Cause-Effect-Pedals/FET-Dream/LTSpice/README.rst

Just a couple of examples of LTSpice file and output from the early conceptual days of the pedal.  Can't support this as I can't get it to run anymore myself!
