Cause-Effect-Pedals/FET-Dream/ExpressPCB/README.rst

This directory includes the custom pcb components, sch components and sch symbols used in the project.
