Cause-Effect-Pedals/FET-Dream/Design_Files/201011-11-j204 value calculations.xls

Adjust Rs trimmer for Vs first then adjust Rd for Vd
2021-02-24
Vcc | 8.44 |  | TR2 | TR1 | W5 | W4 |  |  |  |  | TR2 | TR1
Sample # | Idss (mA) | Vp (V) | Rs (ohm) | Rd (ohm) | Vs (V) | Vd (V) | Id (mA) | Av (V/V) | Vo (Vpp) | Cp (nF) | Fudge | Fudge
1 | 2.481 | 1.2482 | 417.5759774 | 2156.082225 | 0.485 | 5.938 | 1.14 | 2.6 | 5.94 | 381.1400839 | 530.3214913 | 2725.287932
2 | 2.205 | 1.1787 | 443.6829932 | 2482.693878 | 0.457 | 5.889 | 1.01 | 2.8 | 6.08 | 358.7131928 | 563.4774014 | 3138.125061
3 | 2.141 | 1.1554 | 447.9131247 | 2576.496964 | 0.447 | 5.873 | 0.98 | 2.9 | 6.13 | 355.3254734 | 568.8496684 | 3256.692163
4 | 2.1 | 1.1509 | 454.8795238 | 2630.657143 | 0.445 | 5.870 | 0.96 | 2.9 | 6.14 | 349.8837269 | 577.6969952 | 3325.150629
5 | 2.548 | 1.2832 | 417.9968603 | 2074.66248 | 0.500 | 5.962 | 1.18 | 2.5 | 5.87 | 380.7563123 | 530.8560126 | 2622.373375
6 | 2.471 | 1.2515 | 420.3743424 | 2162.403885 | 0.487 | 5.940 | 1.14 | 2.6 | 5.94 | 378.6028952 | 533.8754148 | 2733.278511
7 | 2.507 | 1.2575 | 416.324292 | 2127.044276 | 0.489 | 5.944 | 1.16 | 2.5 | 5.92 | 382.2859875 | 528.7318508 | 2688.583965
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
