Cause-Effect-Pedals/FET-Dream/Design_Files/FET_Dream0v8_c.bmp

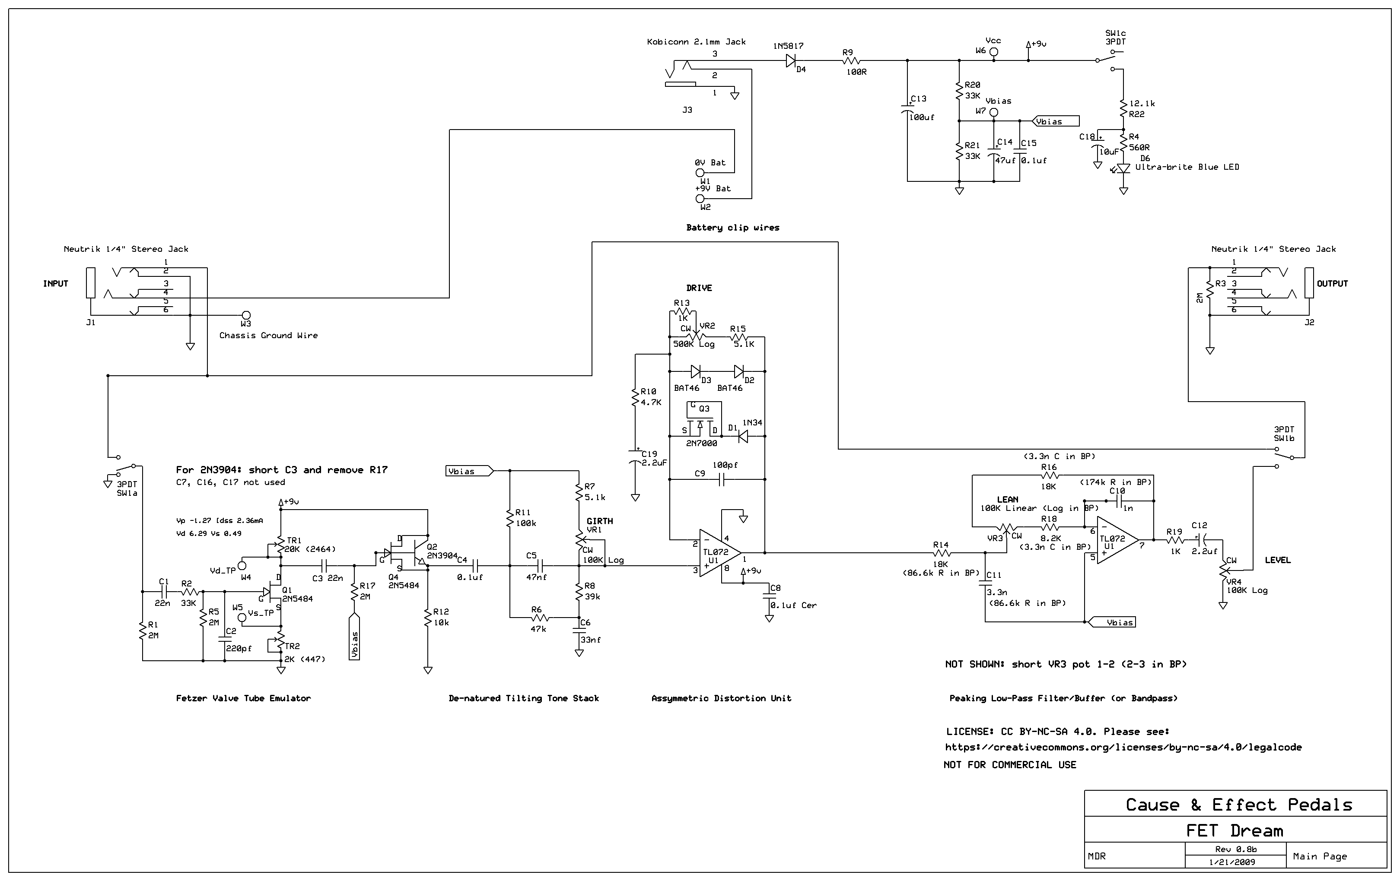
Design_Files/FET_Dream0v8_c.bmp
