Cause-Effect-Pedals/FET-Dream/Design_Files/FET_Selection_Circuit.jpg

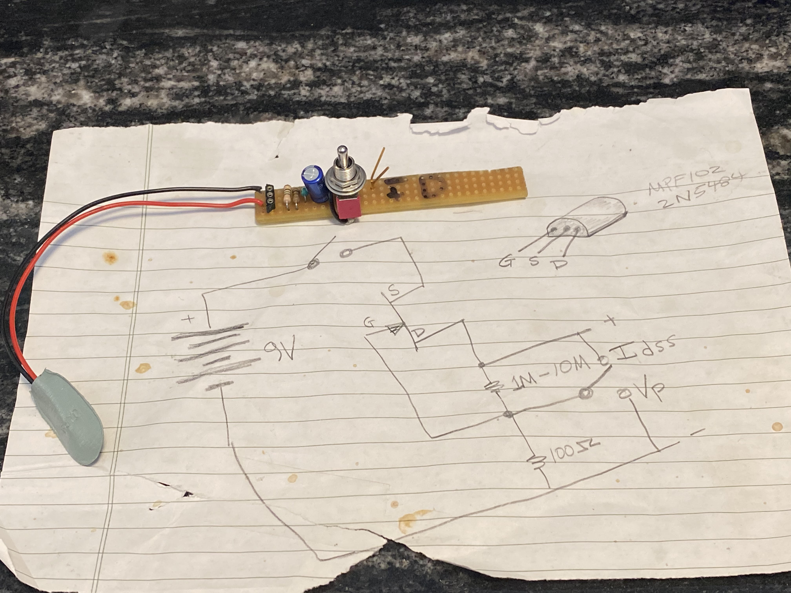
Design_Files/FET_Selection_Circuit.jpg
