Cause-Effect-Pedals/FET-Dream/web-image-w-reflect1000x162.png

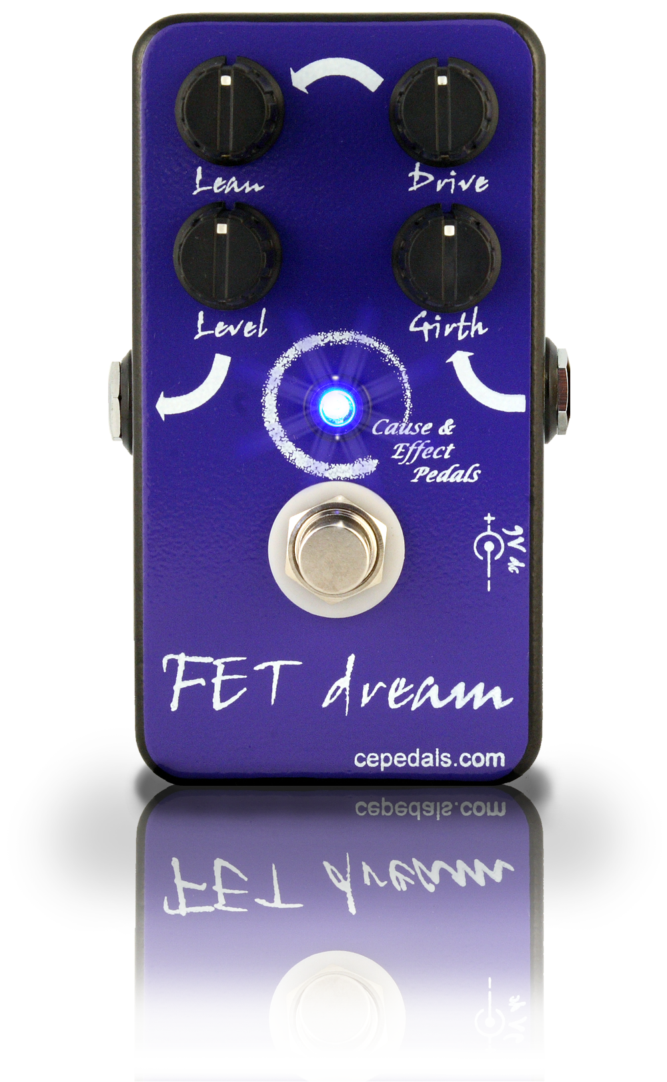
web-image-w-reflect1000x162.png
