Cause-Effect-Pedals/FET-Dream/Design_Files/Dec-20-2009-FET_Dream_BOM_1v2.xls

Part ID | Value | Notes | Mfr Part No. | Source | Src. Part No.
C1 | 0.022uf | Film, coupling | ECQ-B1H223JF | DigiKey | P4586-ND
C10 | .001uF | Film, filter, 2% | ECQ-B1H102JF (5%) | DigiKey | P4551-ND
C11 | .0033uF | Film, filter, 2% | ECQ-B1H332JF (5%) | DigiKey | P4557-ND
C2 | 220pf | Film, filter | ECQ-B1H221KF | DigiKey | P4574-ND
C4 | 0.1uf | Film, coupling | ECQ-V1H104JL | DigiKey | P4525-ND
C5 | 0.047uf | Film, filter, 2% | ECQ-V1H473JL (5%) | DigiKey | P4521-ND
C6 | 0.033uf | Film, filter, 2% | ECQ-B1H333JF (5%) | DigiKey | P4569-ND
Ferrule | 5mm diode ferrule |  | Lumex SSH-LXH501 | DigiKey | 67-1333-ND
Presence | 1uf 63V |  |  | DigiKey | P4548-ND
TR1 | 5K | Murata 10mm | PV36X203C01B00 | DigiKey | 490-2907-ND
TR2 | 1K | Murata 10mm | PV36X202C01B00 | DigiKey | 490-2893-ND
U1 | TL072 | or other 'toneful' op amp | TL072CP | DigiKey | 296-1775-5-ND
Knobs (4) | 1/4" shaft, set screw | ribbed, .625" | PN-8F | Ebay | HongKongSuperSeller
PCB |  |  |  | ExpressPCB
Label |  | Silkscreen | Inkech AM series | Graphic Commerce
Battery | 9V |  | Energizer Max | Loblaws
Bus Bar Wire Extensions for pot leads |  | Beldon | 20 gauge SS wire | Mouser | 566-8020
C12,C19 | 2.2uf - 2mm LS | Electrolytic (coupling) | ECE-A1EKK2R2 | Mouser | 140-MLRH50V2.2-RC
C13,C14 | 100uf - 3.5mm LS | Electrolytic (power) | ECA-1EHG101 2.5mm LS | Mouser | 140-XRL35V100-RC
C18 | 10uf - 2mm LS | Electrolytic (power) | Xicon 140-XRL25V10-RC | Mouser | 140-XRL25V10-RC
C8,C15 | 0.1uf Cer | Ceramic decoupling |  | Mouser | 594-A104K15X7RF5UAA
C9 | 100pf - 2.5mm LS | Ceramic disc, filter | Xicom 140-50P2-101K-RC | Mouser | 140-50S2-101J-RC
D1 | 1N34 | Germanium |  | Mouser | 526-1N34A
D2,D3 | BAT46 | Schottky Barrier | BAT46 | Mouser | 511-BAT46
D4 | 1N5817 | Schottky 20V, 1A | 1N5817 | Mouser | 625-1N5817-E3
D6 | Blue LED 2200mcd | Kingbright 20deg | WP7113QBC/D | Mouser | 604-WP7113QBC/D
J1.J2 | Neutrik 1/4" Stereo Jack |  | NMJ6HCD2 | Mouser | 550-22302
J3 | Kobiconn 2.1mm Jack | PC Mount | 163-179PH-EX | Mouser | 163-179PH-EX
Q1 | J204 | Fetzer | J204-E3 | Mouser | 781-J204-E3
Q2 | 2N3904 | Follower | 2N3904 | Mouser | 512-2N3904D81Z
Q3 | 2N7000 | Distortion MOSFET | 2N7000 | Mouser | 512-2N7000D74Z
R1,R3,R5 | 2M | Metal | Xicon 1% | Mouser | 271-2.0M-RC
R10 | 4.7K | Metal | Xicon 1% | Mouser | 271-4.7K-RC
R11 | 100K | Metal | Xicon 1% | Mouser | 271-100K-RC
R12 | 10K | Metal | Xicon 1% | Mouser | 271-10K-RC
R13,R19 | 1K | Metal | Xicon 1% | Mouser | 271-1K-RC
R14,R16 | 18K | Metal | Xicon 1% | Mouser | 271-18K-RC
R18 | 8.2K | Metal | Xicon 1% | Mouser | 271-8.2K-RC
R2,R20,R21 | 33K | Metal | Xicon 1% | Mouser | 271-33K-RC
R22 | 12K | Metal | Xicon 1% | Mouser | 271-12K-RC
R4 | 560R | Metal | Xicon 1% | Mouser | 271-560-RC
R6 | 47K | Metal | Xicon 1% | Mouser | 271-47K-RC
R7,R15 | 5.1K | Metal | Xicon 1% | Mouser | 271-5.1K-RC
R8 | 39K | Metal | Xicon 1% | Mouser | 271-39K-RC
R9 | 100R | Metal | Xicon 1% | Mouser | 271-100-RC
Socket | 8pin DIP | Tyco 'Econ-Ladder' | 1-390261-2 | Mouser | 571-1-390261-2
VR1,VR4 | 100K Log | Alpha 16mm | RV16AF-10-15S1-A100K | Mouser | 313-1500F-100K
VR2 | 500K Log | Alpha 16mm | RV16AF-10-15S1-A500K | Mouser | 313-1500F-500K
VR3 | 100K Linear | Alpha 16mm | RV16AF-10-15R1-B100K | Mouser | 313-1000F-100K
W1 & W2 | 9V insulated battery clip | Battery clip | Keystone 81-4 | Mouser | 534-81-4
 | Neutrik 1/4" Stereo Jack | J2 Can be mono | NMJ6HCD2 | Mouser | 550-22302
Enclosure | 1290NS | Black Powder Coat | 1290NS | NS | 1290NSBL-16B010
SW1 | 3PDT | EH Blue 3PDT | 3PDT Switch | NS | SW3PDT-03A130
Tooth Washers | Alpha pot tooth washers | "internal tooth" | 7mm internal or .268" | OFS | SS 1/4" tooth washer only
Mailer | D/C 7 1/8 X 5 X 3, 175lb Oyster |  |  | Packaging World
W3 | Chassis Ground Wire | solder to V4 | 22 gauge coated | Sayal
Box | 5"X3"X2" | Oyster | S-461 | Uline | S-461
