Cause-Effect-Pedals/FET-Dream/LTSpice/FET_Dream7_7b_new_filters_LPx3.pdf

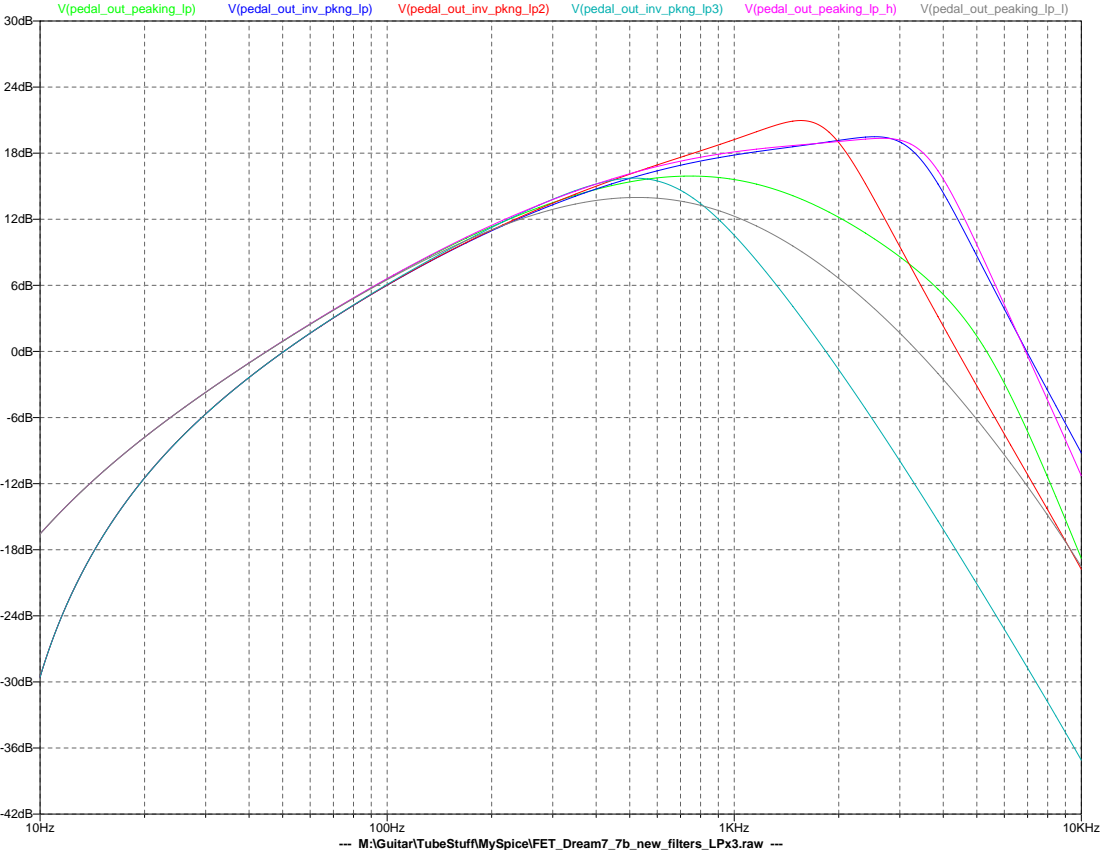
[picture p5: page 1]
1KHz; 10KHz; V(pedal_out_peaking_lp); V(pedal_out_inv_pkng_lp); V(pedal_out_inv_pkng_lp2); V(pedal_out_inv_pkng_lp3); V(pedal_out_peaking_lp_h); V(pedal_out_peaking_lp_l)

--- M:\Guitar\TubeStuff\MySpice\FET_Dream7_7b_new_filters_LPx3.raw ---
