Cause-Effect-Pedals/FET-Dream/FET_Dream_Schematic.pdf

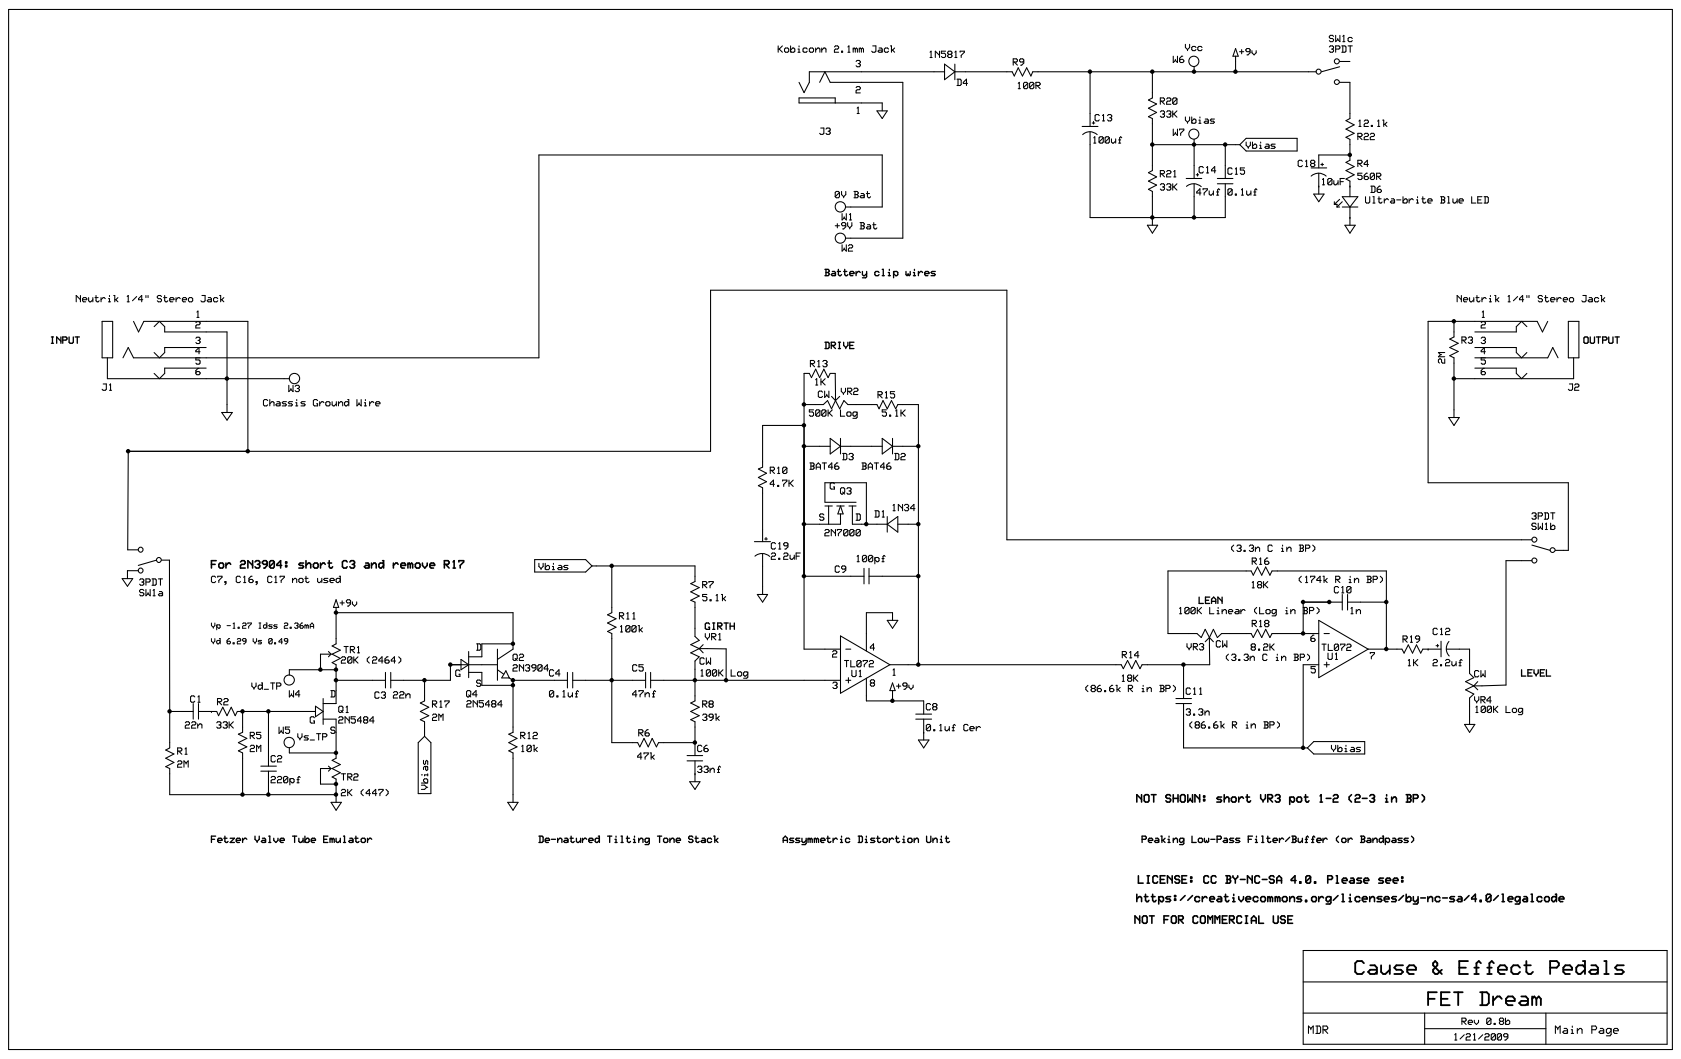
[picture p6: page 1]
