Cause-Effect-Pedals/FET-Dream/LTSpice/FET_Dream_0v8_5_dopple.asc

C1: cap; 33n
C2: cap; 22n
C3: cap; 220p
C4: cap; .22u
C5: cap; 100p
C6: cap; 10n
C7: cap; .47u
C8: cap; 22n
C9: cap; 2.2u
C10: cap; 1n
C11: cap; 33n
C12: cap; 47n
C13: cap; 10u
C14: cap; 47u
C15: cap; 220p
C16: cap; 22n
C17: cap; .1u
C18: cap; 2.2u
C19: cap; 3.3n
C20: cap; 10u
C21: cap; 47u
C22: cap; 22n
C23: cap; 220p
C24: cap; 100p
C25: cap; 1n
C26: cap; 33n
C27: cap; .047u
C28: cap; 47n
C29: cap; 2.2u
C30: cap; 47n
C31: cap; .1u
C32: cap; 10n
C33: cap; 2.2u
C34: cap; 3.3n
C35: cap; 10u
C36: cap; 47u
C39: cap; 100p
C40: cap; 1n
C42: cap; 2.2u
C43: cap; 33n
C44: cap; 47n
C45: cap; 220p
C46: cap; .1u
C47: cap; 2.2u
C48: cap; 3.3n
C49: cap; 10u
C50: cap; 47u
C51: cap; 22n
C53: cap; 100p
C54: cap; 1n
C56: cap; 2.2u
D1: schottky; BAT54
D2: schottky; BAT54
D3: diode; 1N914
D4: diode; 1N914
D5: diode; 1N914
D6: diode; 1N914
D7: schottky; BAT54
D8: diode; 1N914
D9: diode; 1N914
D10: schottky; BAT54
D11: diode; 1N914
D12: diode; 1N914
J1: njf; 2N5484
J2: njf; 2N5484
J3: njf; J112
J4: njf; 2N5484
J5: njf; J112
J6: njf; J112
J7: njf; J201b
Q1: npn; 2N3904
Q2: npn; 2N3904
R1: res; 10k
R2: res; 1
R3: res; 50k
R4: res; 250k
R5: res; 1Meg
R6: res; 33k
R7: res; 33k
R8: res; 816
R9: res; 470k
R10: res; 184
R11: res; 33k
R12: res; 47k
R13: res; 470k
R14: res; 250k
R15: res; 250k
R16: res; 1k
R17: res; 1
R18: res; 18k
R19: res; 1k
R20: res; 97.6k
R21: res; 1
R22: res; 4.7k
R23: res; 2.4k
R24: res; 5.1k
R25: res; 470k
R26: res; 10k
R27: res; 5.1k
R28: res; 10k
R29: res; 39k
R30: res; 100k
R31: res; 2.2meg
R32: res; 33k
R33: res; 816
R34: res; 47k
R35: res; 184
R36: res; 33k
R37: res; 33k
R38: res; 250k
R39: res; 250k
R40: res; 1k
R41: res; 1
R42: res; 18k
R43: res; 1k
R44: res; 98.7k
R45: res; 8.2k
R46: res; 5.1k
R47: res; 2.7k
R48: res; 18k
R49: res; 100k
R50: res; 5.1k
R51: res; 1.3k
R52: res; 39k
R53: res; 1000
R54: res; 1000k
R55: res; 100k
R56: res; 100k
R57: res; 1000k
R58: res; 33k
R59: res; 816
R60: res; 184
R61: res; 33k
R62: res; 33k
R63: res; 250k
R64: res; 250k
R65: res; 1k
R66: res; 18k
R67: res; 1k
R68: res; 98.7k
R69: res; 100k
R70: res; 5.1k
R71: res; 2.7k
R72: res; 2.2Meg
R73: res; 5.1k
R74: res; 1.3k
R75: res; 10k
R76: res; 1000k
R77: res; 4.7k
R78: res; 1
R79: res; 18k
R80: res; 2.2Meg
R81: res; 50k
R82: res; 1
R83: res; 47k
R84: res; 1
R85: res; 1
R86: res; 39k
R87: res; 100k
R88: res; 10k
R89: res; 33k
R90: res; 353
R91: res; 95
R92: res; 33k
R93: res; 33k
R94: res; 250k
R95: res; 250k
R96: res; 1k
R97: res; 18k
R98: res; 1k
R99: res; 98.7k
R100: res; 5.1k
R101: res; 2.7k
R102: res; 1Meg
R103: res; 5.1k
R104: res; 1.3k
R105: res; 100
R107: res; 8.2k
R108: res; 18k
R109: res; 2.2Meg
R110: res; 100k
R111: res; 1
U1: 2N7002
U2: LT1057
U3: 2N7002
U4: LT1057
U5: LT1057
U6: LT1057
U7: 2N7002
U8: LT1057
U9: LT1057
U10: 2N7002
U11: LT1057
U12: LT1057
V1: voltage; SINE(0 1 440); AC 1
V2: voltage; 9; Rser=1
Named nets: 0, Fetzer_Out, Tilt_In, Tilt_Out, Vcc, Vbias, Distort_Out, Pedal_Out_Peaking_LP, Pedal_In, Fetzer_Out2, Tilt_In2, Tilt_Out2, Vbias2, Distort_Out2, Pedal_Out_Inv_Pkng_LP2, Fetzer_Out3, Tilt_In3, Tilt_Out3, Vbias3, Distort_Out3, Pedal_Out_Inv_Pkng_LP3, Fetzer_Out4, Tilt_In4, Tilt_Out4, Vbias4, Distort_Out4, Pedal_Out_Inv_Pkng_LP4, Idss_Test_Point, Vp_Test_Point
;ac oct 25 10 10k
http://www.runoffgroove.com/fetzervalve.html
GAIN POT (500KA)
TILT POT (100k log)
ADJ BIAS
VOLUME
POT (100K)
;op
.tran .02
TONE (10KB)
20k and 10n
12.1k and 10n for less peak, more treble
GAIN POT (500KA)
ADJ BIAS
VOLUME
POT (100K)
TONE (100K-B)
Ideally linear taper
100K for MIN Treble
1 for MAX Treble
GAIN POT (500KA)
ADJ BIAS
VOLUME
POT (100K)
TONE (100K-B)
Ideally linear taper
100K for MIN Treble
1 for MAX Treble
GAIN POT (500KA)
TILT POT (250k log)
ADJ BIAS
VOLUME
POT (100K)
TONE (100K-B)
Ideally linear taper
100K for MIN Treble
1 for MAX Treble
98.7k with 1.3k for unity
when gain is 250k-250k
97.6k with 2.4k for unity
when gain is 250k-250k
98.7k with 1.3k for unity
when gain is 250k-250k
98.7k with 1.3k for unity
when gain is 250k-250k
TILT POT (100k log)
TILT POT (100k log)
;noise V(fetzer_out3) V1 oct 25 10 10k
