Cause-Effect-Pedals/FET-Dream/(list of files, drawings)

Other design files:
Design_Files/FET_Dream_1v0_8_1c_prod2.pcb
