Cause-Effect-Pedals/FET-Dream/(commit log)

2021-02-25 Add files via upload
    Added PDF of schematic at highest level
2021-02-25 Add files via upload
    PCB Components
2021-02-25 Update README.rst
    Added description of the build options and explained the 2N5484 vs. J204 FET choice.
2021-02-26 Added circuit used to select FET
    Picture of circuit diagram and stripboard jig used to select the jFET. As mentioned, J204 was used in production.
2021-02-26 Update README.rst
    Added jFET characterization board.
