Cause-Effect-Pedals/FET-Dream/(notices)

Notices in the files:
Design_Files/201011-11-j204 value calculations.xls:
LICENSE CC BY-NC-SA-4.0
